edodso2/FoxFobz/hardware/fob/releases/README.md

# Fob releases

One folder per ordered revision (`revA/`, `revB/`…), holding exactly what was sent to the fab. See [../../README.md](../../README.md#revisions-and-releases).
