edodso2/FoxFobz/testing/README.md

# Testing

| Folder | What |
|---|---|
| [bench/](bench/) | Bench tests and board bring-up logs (circuit investigation, revA bring-up…) |
| [vehicle/](vehicle/) | One log per car session: `YYYY-MM-DD-<vehicle>-<environment>.md` |
| [templates/](templates/) | [test-log.md](templates/test-log.md). Copy it for each session |

After each session, add a row to [docs/compatibility.md](../docs/compatibility.md). The M5 exit criteria are in [docs/roadmap.md](../docs/roadmap.md#m5--field-test-passes--current-product-goal).
