edodso2/FoxFobz/hardware/receiver/FoxFobz_Reciever.kicad_pcb

## KiCad design hardware/receiver/FoxFobz_Reciever.kicad_pcb (2026-10-25)

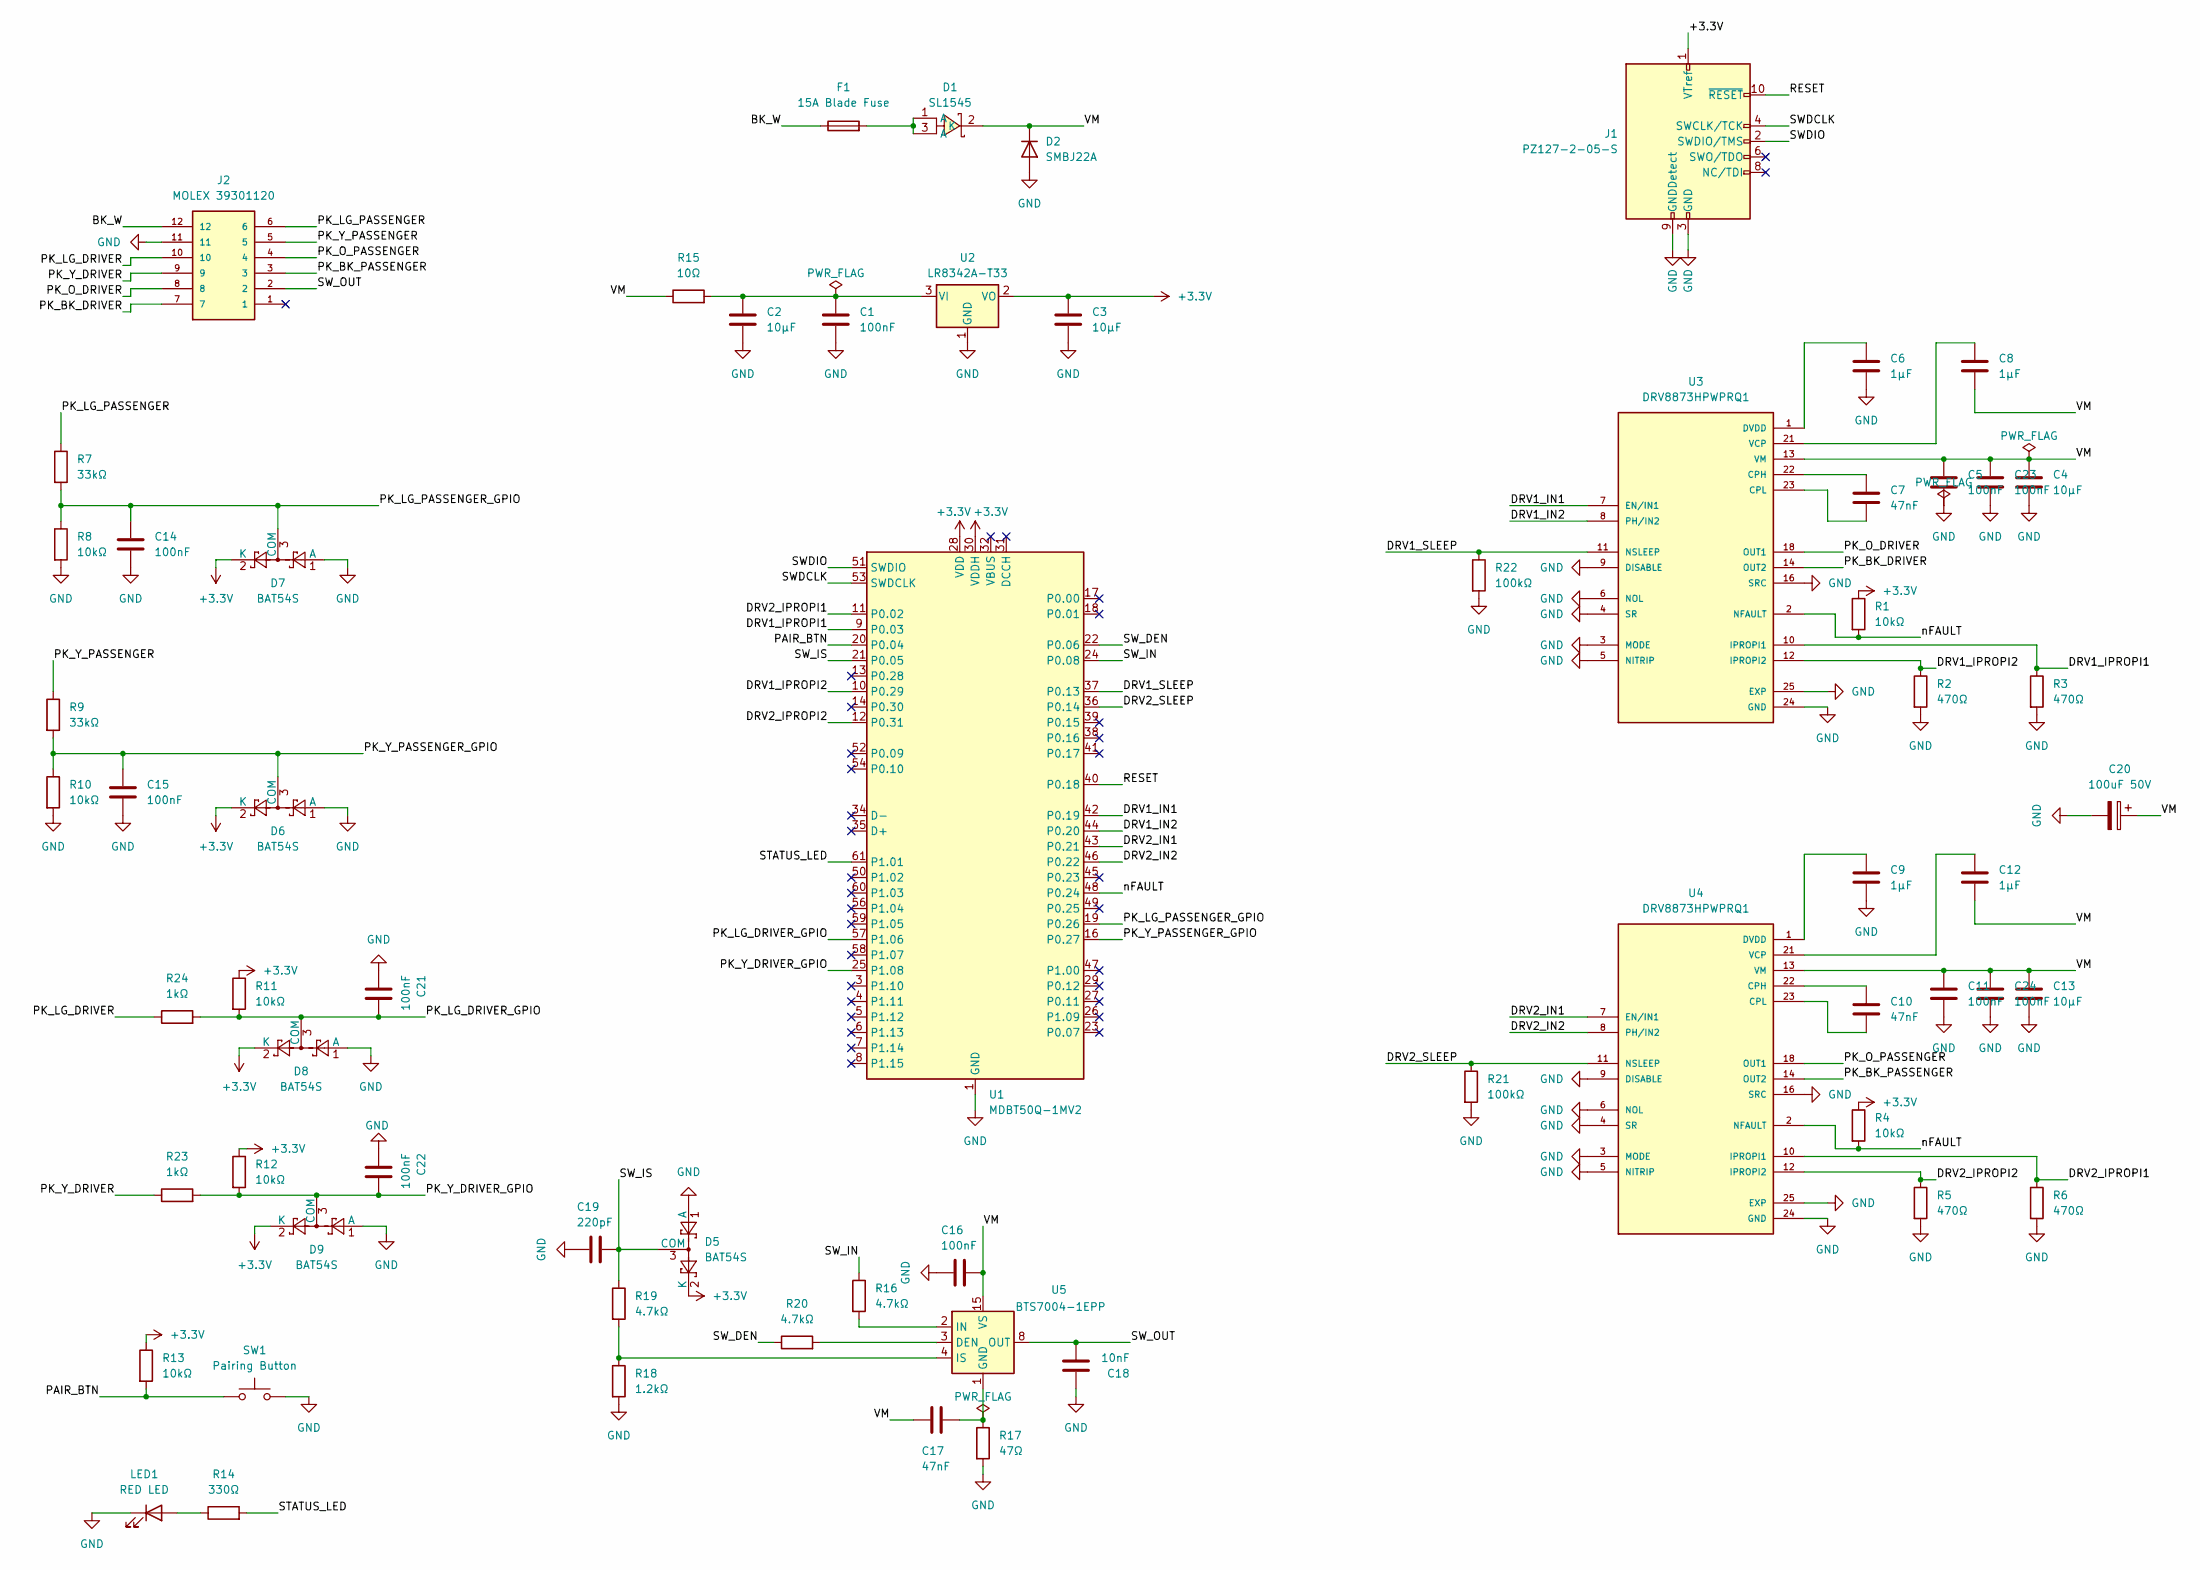
[picture p2: schematic FoxFobz_Reciever.kicad_sch]

Parts:
C1, C5, C11, C16, C21, C22, C23, C24: 100nF; C_0402_1005Metric; LCSC C307331
C2, C4, C13: 10µF; C_1206_3216Metric; LCSC C13585
C3: 10µF; C_0805_2012Metric; LCSC C32635
C6, C8, C9, C12: 1µF; C_0402_1005Metric; LCSC C52923
C7, C10, C17: 47nF; C_0402_1005Metric; LCSC C272875
C14, C15: 100nF; C_0402_1005Metric; LCSC C100072
C18: 10nF; C_0402_1005Metric; LCSC C1710
C19: 220pF; C_0402_1005Metric; LCSC C1603
C20: 100uF 50V; CP_Elec_8x10; LCSC C5250964
D1: SL1545; MPN SL1545; LCSC C65022
D2: SMBJ22A; D_SMB; LCSC C726829
D5, D6, D7, D8, D9: BAT54S; SOT-23; LCSC C8592
F1: 15A Blade Fuse; FUSE_3568; LCSC C5249699
J1: PZ127-2-05-S; PinHeader_2x05_P1.27mm_Vertical_SMD; LCSC C3975188
J2: MOLEX 39301120; 39301120; PARTREV F1; LCSC C485574
LED1: RED LED; LED_0805_2012Metric; LCSC C84256
R1, R4, R8, R10, R11, R12, R13: 10kΩ; R_0402_1005Metric; LCSC C25744
R2, R3, R5, R6: 470Ω; R_0402_1005Metric; LCSC C25117
R7, R9: 33kΩ; R_0402_1005Metric; LCSC C25779
R14: 330Ω; R_0402_1005Metric; LCSC C17630
R15: 10Ω; R_0402_1005Metric; LCSC C25077
R16, R19, R20: 4.7kΩ; R_0402_1005Metric; LCSC C174177
R17: 47Ω; R_0402_1005Metric; LCSC C174246
R18: 1.2kΩ; R_0402_1005Metric; LCSC C25862
R21, R22: 100kΩ; R_0402_1005Metric; LCSC C25530
R23, R24: 1kΩ; R_0402_1005Metric; LCSC C11702
SW1: Pairing Button; SW_SPST_TL3342; LCSC C318884
U1: MDBT50Q-1MV2; Raytac_MDBT50Q; LCSC C5118826
U2: LR8342A-T33; SOT-23; LCSC C29781219
U3, U4: DRV8873HPWPRQ1; SOP65P640X120-25N; PARTREV AUG2018; DigiKey_Part_Number 296-50274-1-ND
U5: BTS7004-1EPP; Infineon_PG-TSDSO-14-22; LCSC C3232437

Connections:
+3.3V: C3.1, D5.2 (K), D6.2 (K), D7.2 (K), D8.2 (K), D9.2 (K), J1.1 (VTref), R1.1, R4.1, R11.1, R12.1, R13.1, U1.28 (VDD), U1.30 (VDDH), U2.2 (VO)
/BK_W: F1.1, J2.12
/DRV1_IN1: U1.42 (P0.19), U3.7 (EN/IN1)
/DRV1_IN2: U1.44 (P0.20), U3.8 (PH/IN2)
/DRV1_IPROPI1: R3.1, U1.9 (P0.03), U3.10 (IPROPI1)
/DRV1_IPROPI2: R2.1, U1.10 (P0.29), U3.12 (IPROPI2)
/DRV1_SLEEP: R22.1, U1.37 (P0.13), U3.11 (NSLEEP)
/DRV2_IN1: U1.43 (P0.21), U4.7 (EN/IN1)
/DRV2_IN2: U1.46 (P0.22), U4.8 (PH/IN2)
/DRV2_IPROPI1: R6.1, U1.11 (P0.02), U4.10 (IPROPI1)
/DRV2_IPROPI2: R5.1, U1.12 (P0.31), U4.12 (IPROPI2)
/DRV2_SLEEP: R21.1, U1.36 (P0.14), U4.11 (NSLEEP)
/PAIR_BTN: R13.2, SW1.1, U1.20 (P0.04)
/PK_BK_DRIVER: J2.7, U3.14 (OUT2), U3.15 (OUT2)
/PK_BK_PASSENGER: J2.3, U4.14 (OUT2), U4.15 (OUT2)
/PK_LG_DRIVER: J2.10, R24.1
/PK_LG_DRIVER_GPIO: C21.1, D8.3 (COM), R11.2, R24.2, U1.57 (P1.06)
/PK_LG_PASSENGER: J2.6, R7.1
/PK_LG_PASSENGER_GPIO: C14.1, D7.3 (COM), R7.2, R8.1, U1.19 (P0.26)
/PK_O_DRIVER: J2.8, U3.18 (OUT1), U3.19 (OUT1)
/PK_O_PASSENGER: J2.4, U4.18 (OUT1), U4.19 (OUT1)
/PK_Y_DRIVER: J2.9, R23.1
/PK_Y_DRIVER_GPIO: C22.1, D9.3 (COM), R12.2, R23.2, U1.25 (P1.08)
/PK_Y_PASSENGER: J2.5, R9.1
/PK_Y_PASSENGER_GPIO: C15.1, D6.3 (COM), R9.2, R10.1, U1.16 (P0.27)
/RESET: J1.10 (~RESET), U1.40 (P0.18)
/STATUS_LED: R14.2, U1.61 (P1.01)
/SWDCLK: J1.4 (SWCLK/TCK), U1.53 (SWDCLK)
/SWDIO: J1.2 (SWDIO/TMS), U1.51 (SWDIO)
/SW_DEN: R20.1, U1.22 (P0.06)
/SW_IN: R16.1, U1.24 (P0.08)
/SW_IS: C19.1, D5.3 (COM), R19.1, U1.21 (P0.05)
/SW_OUT: C18.1, J2.2, U5.8 (OUT), U5.9 (OUT), U5.10 (OUT), U5.12 (OUT), U5.13 (OUT), U5.14 (OUT)
/nFAULT: R1.2, R4.2, U1.48 (P0.24), U3.2 (NFAULT), U4.2 (NFAULT)
GND: C1.2, C2.2, C3.2, C4.2, C5.2, C6.2, C9.2, C11.2, C13.2, C14.2, C15.2, C16.2, C18.2, C19.2, C20.2, C21.2, C22.2, C23.2, C24.2, D2.2 (A), D5.1 (A), D6.1 (A), D7.1 (A), D8.1 (A), D9.1 (A), J1.3 (GND), J1.5 (GND), J1.9 (GNDDetect), J2.11, LED1.1 (K), R2.2, R3.2, R5.2, R6.2, R8.2, R10.2, R17.2, R18.2, R21.2, R22.2, SW1.2, U1.1 (GND), U1.2 (GND), U1.15 (GND), U1.33 (GND), U1.55 (GND), U2.1 (GND), U3.3 (MODE), U3.4 (SR), U3.5 (NITRIP), U3.6 (NOL), U3.9 (DISABLE), U3.16 (SRC), U3.17 (SRC), U3.24 (GND), U3.25 (EXP), U3.P1 (EXP), U3.P2 (EXP), U3.P3 (EXP), U3.P4 (EXP), U3.P5 (EXP), U3.P6 (EXP), U3.P7 (EXP), U3.P8 (EXP), U3.P9 (EXP), U3.P10 (EXP), U3.P11 (EXP), U3.P12 (EXP), U3.P13 (EXP), U3.P14 (EXP), U3.P15 (EXP), U3.P16 (EXP), U3.P17 (EXP), U3.P18 (EXP), U4.3 (MODE), U4.4 (SR), U4.5 (NITRIP), U4.6 (NOL), U4.9 (DISABLE), U4.16 (SRC), U4.17 (SRC), U4.24 (GND), U4.25 (EXP), U4.P1 (EXP), U4.P2 (EXP), U4.P3 (EXP), U4.P4 (EXP), U4.P5 (EXP), U4.P6 (EXP), U4.P7 (EXP), U4.P8 (EXP), U4.P9 (EXP), U4.P10 (EXP), U4.P11 (EXP), U4.P12 (EXP), U4.P13 (EXP), U4.P14 (EXP), U4.P15 (EXP), U4.P16 (EXP), U4.P17 (EXP), U4.P18 (EXP)
unnamed: D1.1 (A), D1.3 (A), F1.2
unnamed: LED1.2 (A), R14.1
unnamed: C1.1, C2.1, R15.2, U2.3 (VI)
unnamed: C7.1, U3.22 (CPH)
unnamed: C7.2, U3.23 (CPL)
unnamed: C6.1, U3.1 (DVDD)
unnamed: C8.1, U3.21 (VCP)
unnamed: C10.1, U4.22 (CPH)
unnamed: C10.2, U4.23 (CPL)
unnamed: C9.1, U4.1 (DVDD)
unnamed: C12.1, U4.21 (VCP)
unnamed: R20.2, U5.3 (DEN)
unnamed: C17.1, R17.1, U5.1 (GND)
unnamed: R16.2, U5.2 (IN)
unnamed: R18.1, R19.2, U5.4 (IS)
VM: C4.1, C5.1, C8.2, C11.1, C12.2, C13.1, C16.1, C17.2, C20.1, C23.1, C24.1, D1.2 (K), D2.1 (K), R15.1, U3.13 (VM), U3.20 (VM), U4.13 (VM), U4.20 (VM), U5.15 (VS)

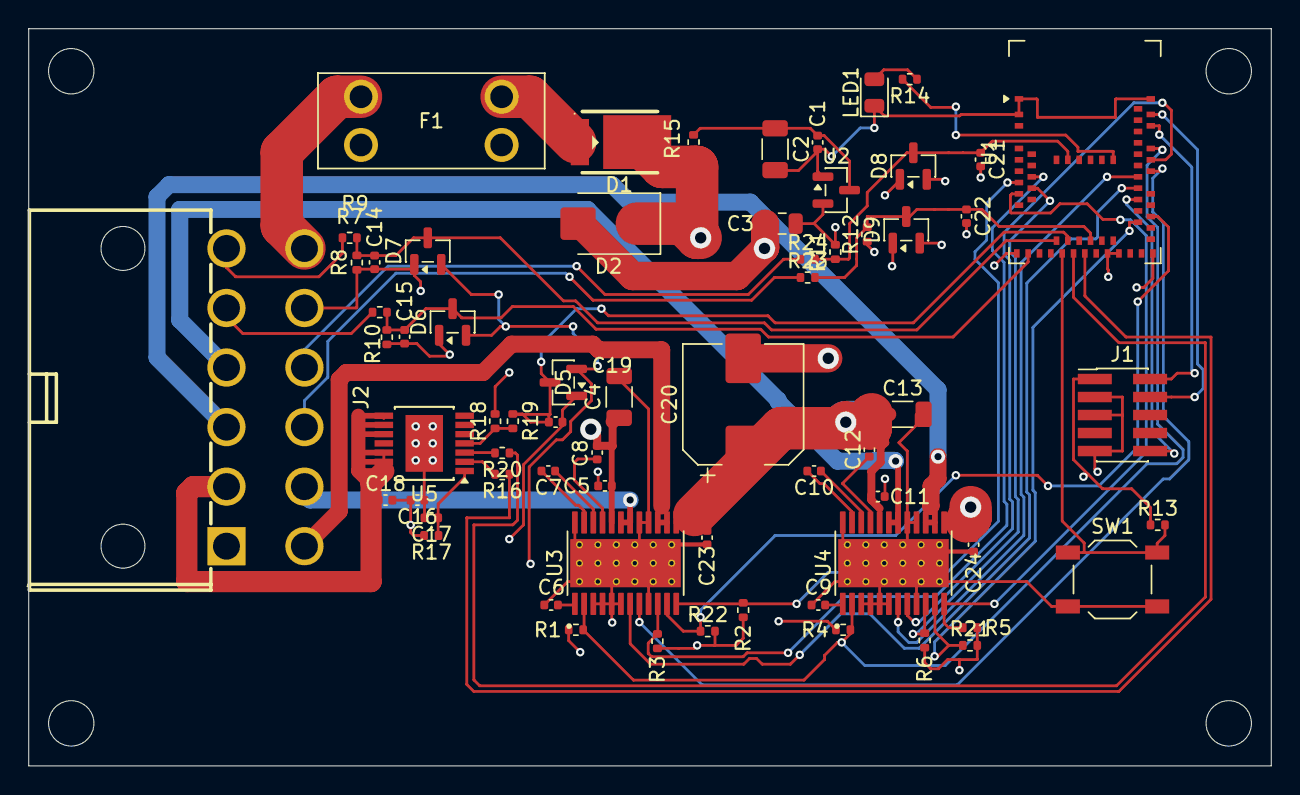
[picture p3: board FoxFobz_Reciever.kicad_pcb from above]

Board: 4 copper layers, 87.7 x 52.0 mm, 69 parts (0 on the bottom side), 51 nets.

Other parts of the board:
H1, H2, H3, H4: M3; MountingHole_3.2mm_M3
