edodso2/FoxFobz/(commit log)

2026-10-24 Import existing Fox Fobz sources into monorepo
    Copied as-is (fresh copy, no history) from:
    - ~/Documents/ki-cad/FoxFobz_Reciever @ 4-layer-experiment 4ef8637 -> hardware/receiver
    - foxfobz-dev/reciever_firmware (working tree) -> firmware/receiver
    - foxfobz-dev/fob_firmware (working tree) -> firmware/fob
    - foxfobz-dev/fob_hub (working tree) -> app
    - foxfobz-dev/foxfobz-website @ 108e103 -> web
    - foxfobz-dev/foxfobz-business (working tree) -> business
    - ~/Documents/FoxFobz @ dbdf532 + uncommitted v3/pin docs -> docs, hardware/receiver/docs, testing/bench
    Datasheets de-duplicated into docs/datasheets. App BLE protocol doc
    moved to docs/protocol. Bench tests split out of the phase 5 doc.
    Co-Au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
    [FoxFobz_Reciever.kicad_pcb, FoxFobz_Reciever.kicad_sch, early-bom.csv]
2026-10-24 firmware: VERSION files, boot version banner, build/flash scripts, merged docs
    - VERSION (Zephyr native) per app, starting at 0.1.0
    - common/foxfobz.cmake: shared include path + git-describe build id
    scoped to <app>-fw/* tags; printed at boot
    - scripts/build.sh, scripts/flash.sh (J-Link SWD @ 500 kHz)
    - README.md/CLAUDE.md merge the two duplicated flashing docs and the
    per-app READMEs
2026-10-24 Add repo docs: status board, roadmap, decisions, versioning, compatibility
    - README/CLAUDE.md/STATUS.md at root; per-area CLAUDE.md for hardware, web
    - docs/roadmap.md: parallel workstreams + milestones M1-M6 (replaces
    sequential phases; phase docs kept as topic specs)
    - docs/decisions: ADRs 0001-0008
    - docs/compatibility.md + testing/templates/test-log.md
    - hardware/README.md: revision/release process; fob + dev-rig placeholders
    - docs/protocol/ble-protocol.md now points at protocol.h as source of truth
    - Banners on stale docs (plan v2/v3, early pin plan, phase 6)
    - Shared .claude/settings.json, root .mcp.json (Dart), VS Code workspace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
2026-10-24 docs: retire docs/product; extract what's still live
    - docs/security.md: trust model, provisioning, RMA, signing (from v2
    plan + phase 4), updated for the broadcast fob; fob auth marked open
    - docs/production/compliance.md: phase 6 with MDBT42T FCC ID for fob
    - docs/backlog.md: parked feature ideas (v2 list, phase 7, app future)
    - hardware/fob/README.md: fob requirements + KiCad checklist (MDBT42T)
    - Brief moved to business/ as the shareable project overview
    - Plan v2/v3 and phase docs removed (superseded; still in the archived
    planning repo). Open questions moved to STATUS.md.
2026-10-24 Drop stale early receiver pin plan and BOM; fix references
    [early-bom.csv]
2026-10-25 Clean up reciever imports and pretty files
    [FoxFobz_Reciever.kicad_pcb, TSSOP-14_L5.0-W4.4-H1.0-LS6.4-P0.65.step]
